villagekit/gridbot-tahi/(list of files, cad)

Other CAD files:
dxfs/length_side_cover_plate.dxf
stls/dq542ma_din_mount.stl
dxfs/length_axis_motor_side_plate.dxf
stls/stm32_f7676zi_din_mount.stl
dxfs/length_axis_bottom_plate.dxf
dxfs/width_axis_plate.dxf
dxfs/spindle_plate.dxf
dxfs/spindle_plate_spacer.dxf
