villagekit/gridbot-tahi/(commit log)

2021-03-23 in the beginning
    [main.scad]
2021-03-23 nopscadlib build works
    [main.scad]
2021-03-23 change beam alignments, add motor and mount
    [main.scad]
2021-03-24 comments and formatting
    [main.scad]
2021-03-24 fix dxf usage
    [main.scad]
2021-03-25 pitter potter
    [main.scad]
2021-03-25 add rough support seats and respective bearings
    [main.scad]
2021-03-26 add gang of drills
    [main.scad]
2022-04-04 v2 (#2)
    a new approach, basically a two axis cnc machine.
    [gear_rack_motor_mount_plate.dxf, length_axis_plate.dxf, lib.scad, main.scad, spindle_plate.dxf, spindle_plate_spacer.dxf, support_seat.stl, width_axis_plate.dxf]
2022-06-07 joining plates (#4)
    [joining-plates.scad, lib.scad]
2022-06-08 center joining plates
    [joining-plates.scad]
2022-06-08 add l brackets (#6)
    [l-brackets.scad, lib.scad]
2022-06-08 center l brackets
    [l-brackets.scad]
2022-06-08 more l bracket goodness
    [l-brackets.scad]
2022-06-08 raise legs (#3)
    [l-brackets.scad, lib.scad, main.scad]
2022-06-08 4 legs
    [main.scad]
2022-06-08 interconnect between workholding and length axis
    [main.scad]
2022-09-20 rack and pinion (#7)
    [gear_rack_motor_mount_plate.dxf, l-brackets.scad, length_axis_bottom_plate.dxf, length_axis_plate.dxf, length_axis_side_plate.dxf, lib.scad, main.scad, rack-and-pinion.scad]
2022-09-21 use hgh15ca rails and carriages, rebuild
    [length_axis_bottom_plate.dxf, length_axis_side_plate.dxf, main.scad, width_axis_plate.dxf]
2022-10-20 resize workholding
    [main.scad]
2022-10-20 more space for rack and pinion
    [main.scad]
2022-11-09 add length side plate
    [length_axis_motor_side_plate.dxf, length_side_cover_plate.dxf, main.scad]
2023-04-25 dragchain (#8)
    add connection point for drag chain
    [length_axis_motor_side_plate.dxf, main.scad]
2023-05-05 add 3d printable din mount for stm32-f767zi microcontroller (#9)
    [din.scad, lib.scad, main.scad, stm32_f7676zi_din_mount.stl]
2023-05-05 add holes for limit switch wires to length side cover plate (#10)
    [length_side_cover_plate.dxf, main.scad]
2023-05-15 make dq542ma mount
    [din.scad, main.scad]
2023-05-15 a new approach
    [main.scad]
2023-05-16 refine and build
    [dq542ma_din_mount.stl, dq542ma_mount_1.stl, dq542ma_mount_2.stl, main.scad]
